NorbotNorway/KiCadTeensyFolkracePro/README.md

# KiCadTeensyFolkracePro
PCB made with KiCad. For Teensy and i2c GP2Y... sensor

(The JST SH 1mm connectors are from http://www.kicadlib.org/)
