NorbotNorway/KiCadTeensyFolkracePro/Schematic/KiCadTeensyFolkraceProSchematic.pdf

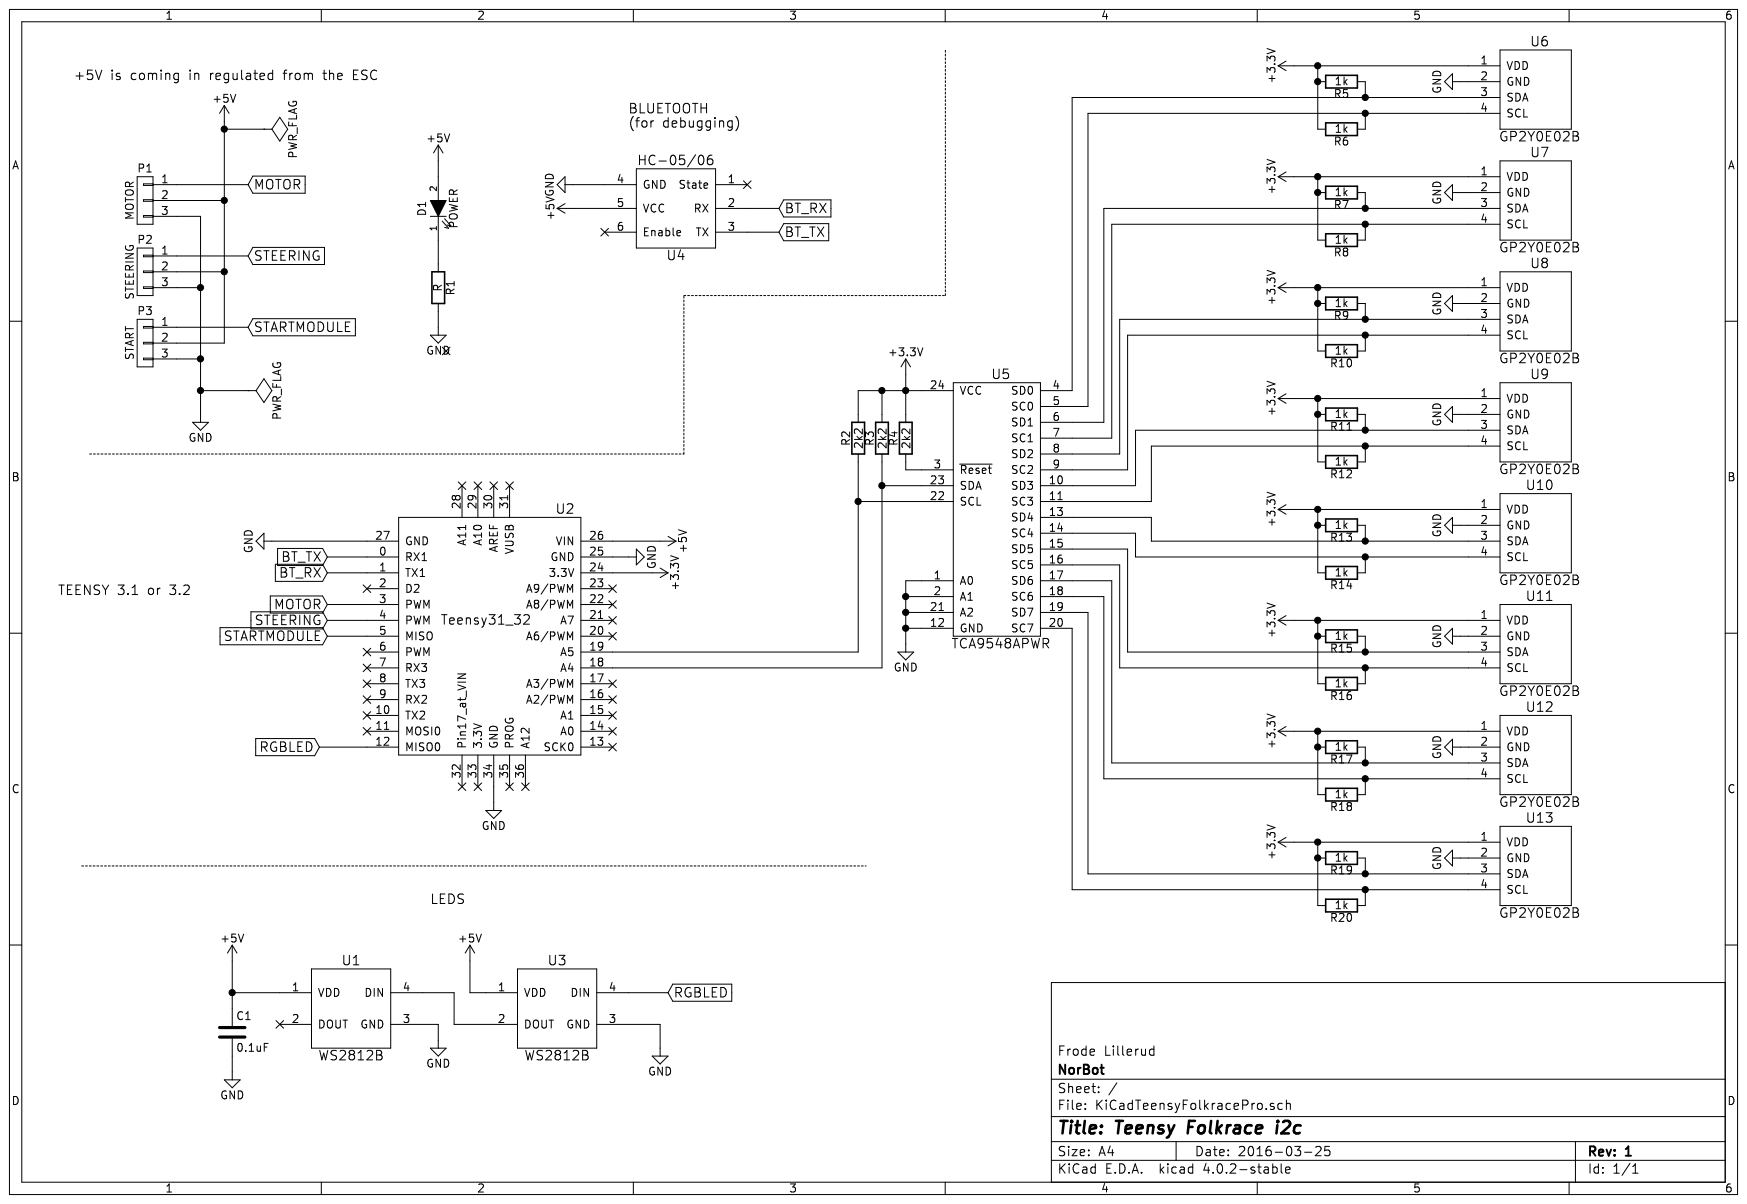
[picture p1: page 1]
