NorbotNorway/KiCadTeensyFolkracePro/KiCadTeensyFolkracePro.kicad_pcb

## KiCad design KiCadTeensyFolkracePro.kicad_pcb (2016-04-30)

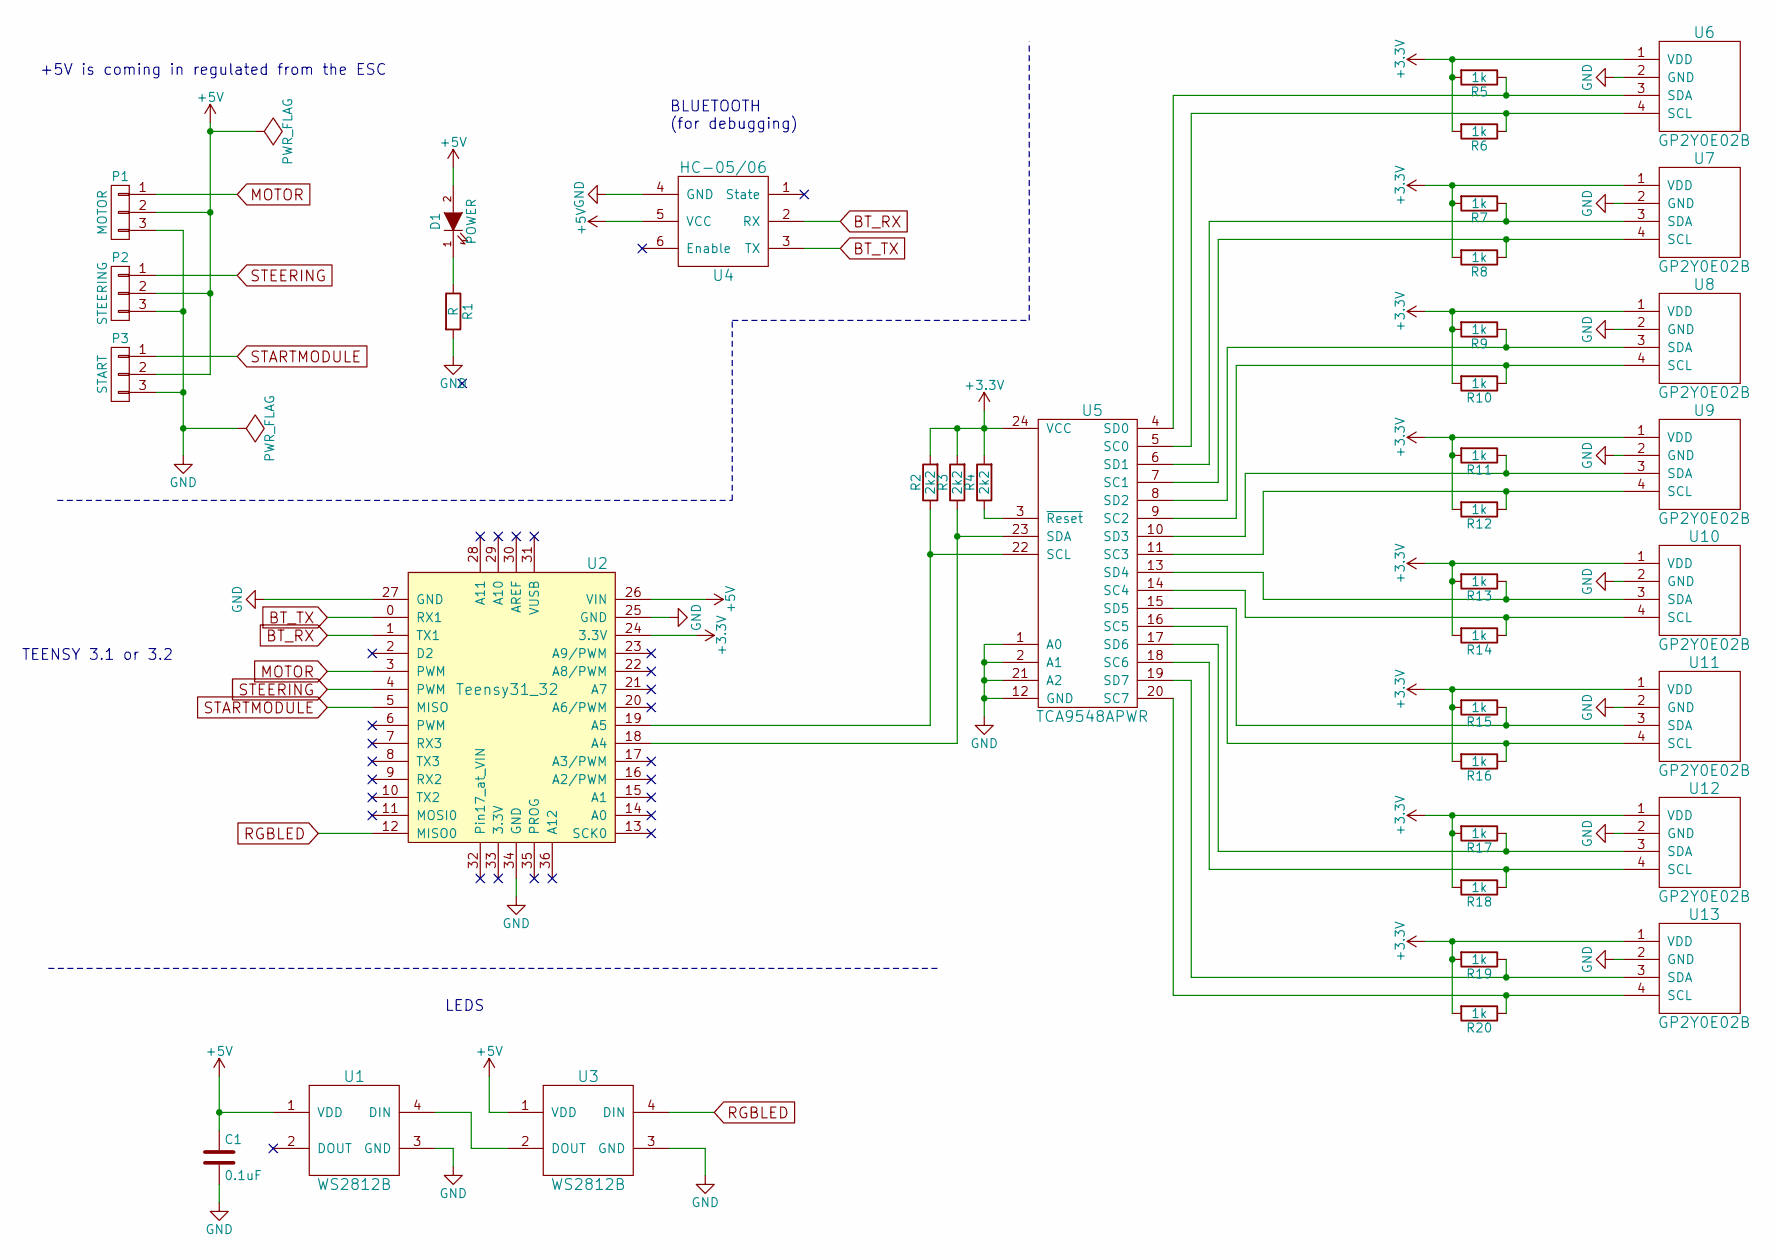
[picture p2: schematic KiCadTeensyFolkracePro.sch, Teensy Folkrace i2c]

Parts:
C1: 0.1uF; C_0805
D1: POWER; R_0603
P1: MOTOR; Pin_Header_Straight_1x03
P2: STEERING; Pin_Header_Straight_1x03
P3: START; Pin_Header_Straight_1x03
R1: R; R_0603
R2, R3, R4: 2k2; R_0603
R5, R6, R7, R8, R9, R10, R11, R12, R13, R14, R15, R16, R17, R18, R19, R20: 1k; R_0603
U1, U3: WS2812B
U2: Teensy31_32; Teensy-3.1_3.2
U4: HC-05/06; Pin_Header_Straight_1x06
U5: TCA9548APWR; TSSOP-24_4.4x7.8mm_Pitch0.65mm
U6, U7, U8, U9, U10, U11, U12, U13: GP2Y0E02B; JST-BM-04B-SRSS-TB

Connections:
+3V3: R2.2, R3.2, R4.2, R5.2, R6.2, R7.2, R8.2, R9.2, R10.2, R11.2, R12.2, R13.2, R14.2, R15.2, R16.2, R17.2, R18.2, R19.2, R20.2, U2.24 (3.3V), U5.24 (VCC), U6.1 (VDD), U7.1 (VDD), U8.1 (VDD), U9.1 (VDD), U10.1 (VDD), U11.1 (VDD), U12.1 (VDD), U13.1 (VDD)
+5V: C1.1, D1.2 (A), P1.2, P2.2, P3.2, U1.1 (VDD), U2.26 (VIN), U3.1 (VDD), U4.5 (VCC)
BT_RX: U2.1 (TX1), U4.2 (RX)
BT_TX: U2.0 (RX1), U4.3 (TX)
GND: C1.2, P1.3, P2.3, P3.3, R1.2, U1.3 (GND), U2.25 (GND), U2.27 (GND), U2.34 (GND), U3.3 (GND), U4.4 (GND), U5.1 (A0), U5.2 (A1), U5.12 (GND), U5.21 (A2), U6.2 (GND), U7.2 (GND), U8.2 (GND), U9.2 (GND), U10.2 (GND), U11.2 (GND), U12.2 (GND), U13.2 (GND)
MOTOR: P1.1, U2.3 (PWM)
unnamed: D1.1 (K), R1.1
unnamed: R2.1, U2.19 (A5), U5.22 (SCL)
unnamed: R3.1, U2.18 (A4), U5.23 (SDA)
unnamed: R4.1, U5.3 (~Reset)
unnamed: R5.1, U5.4 (SD0), U6.3 (SDA)
unnamed: R6.1, U5.5 (SC0), U6.4 (SCL)
unnamed: R7.1, U5.6 (SD1), U7.3 (SDA)
unnamed: R8.1, U5.7 (SC1), U7.4 (SCL)
unnamed: R9.1, U5.8 (SD2), U8.3 (SDA)
unnamed: R10.1, U5.9 (SC2), U8.4 (SCL)
unnamed: R11.1, U5.10 (SD3), U9.3 (SDA)
unnamed: R12.1, U5.11 (SC3), U9.4 (SCL)
unnamed: R13.1, U5.13 (SD4), U10.3 (SDA)
unnamed: R14.1, U5.14 (SC4), U10.4 (SCL)
unnamed: R15.1, U5.15 (SD5), U11.3 (SDA)
unnamed: R16.1, U5.16 (SC5), U11.4 (SCL)
unnamed: R17.1, U5.17 (SD6), U12.3 (SDA)
unnamed: R18.1, U5.18 (SC6), U12.4 (SCL)
unnamed: R19.1, U5.19 (SD7), U13.3 (SDA)
unnamed: R20.1, U5.20 (SC7), U13.4 (SCL)
unnamed: U1.4 (DIN), U3.2 (DOUT)
RGBLED: U2.12 (MISO0), U3.4 (DIN)
STARTMODULE: P3.1, U2.5 (MISO)
STEERING: P2.1, U2.4 (PWM)

Notes on the sheet:
+5V is coming in regulated from the ESC
BLUETOOTH (for debugging)
LEDS
TEENSY 3.1 or 3.2

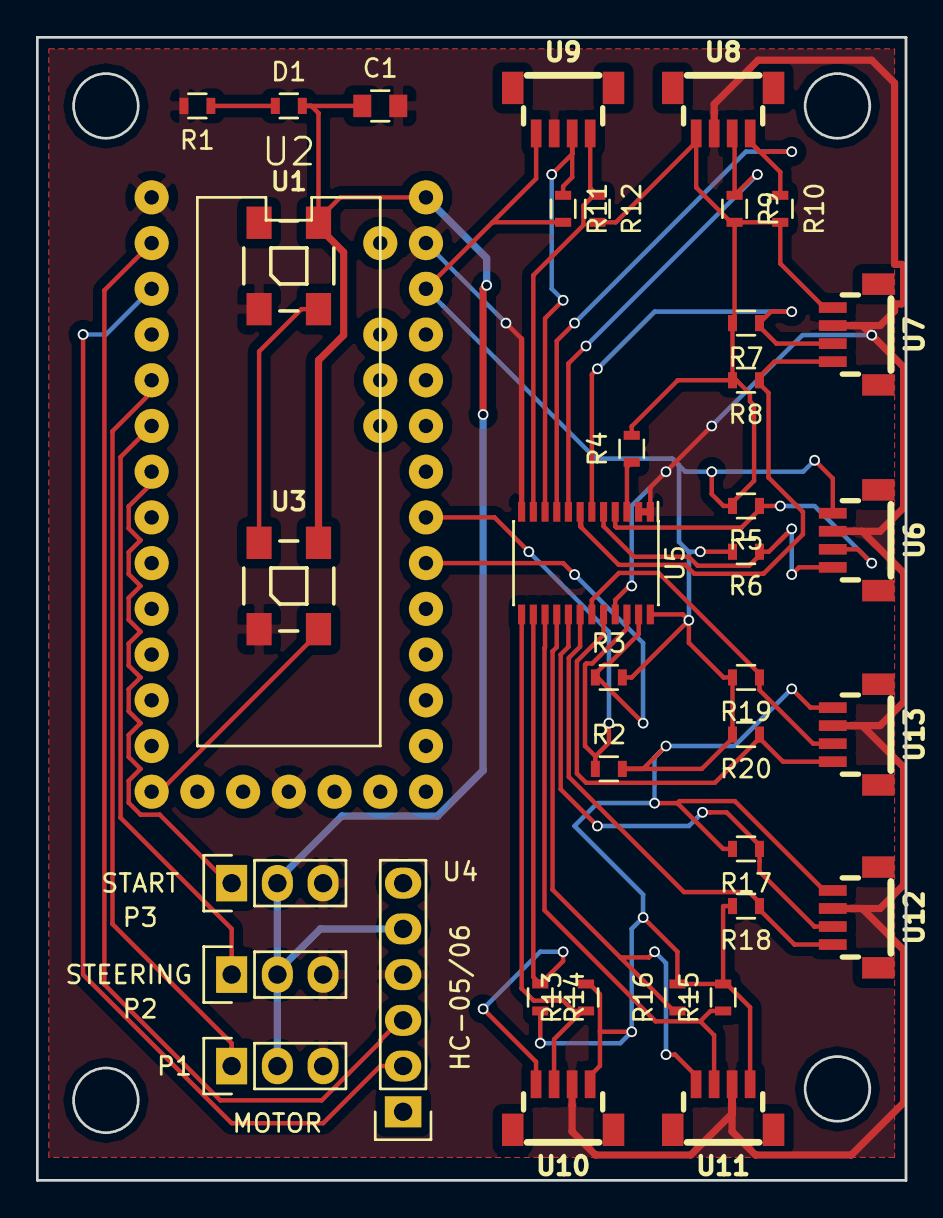
[picture p3: board KiCadTeensyFolkracePro.kicad_pcb from above]

Board: 2 copper layers, 48.3 x 63.5 mm, 38 parts (0 on the bottom side), 30 nets.
