NorbotNorway/KiCadTeensyFolkracePro/Problems.txt

Problems with this card:

- The 4-pin sensorheaders are reversed. They don't match the colorcodes on the wires. Need to mirror the connections. Switch pins 1 and 4, and 2 and 3. The connectors doesn't have to be along the edge of the board.

- Bluetooth header is too close to the 3-pin headers. Bluetooth header should be turned around, or moved. Maybe move it to the back, and make it a right-angle connector which points bluetooth device backwards?

- Too big. Card should be slimmer, and longer.

- Startmodule should be plugged directly into a _female_ 3 or 4-pin header. Note the order of the pins!

- LEDS in the front of the PCB which can be used for debugging?

- Power to Startmodule should come from Teensy digital pin, so that it can be powercycled via software. How much current does it draw, and how much can output pin from Teensy supply?

- Need a way to figure out how much juice is left in the battery...

- PCB needs better indication of which connector is which
