NorbotNorway/KiCadTeensyFolkracePro/Arduino/folkracer/config.h

//Define address location in EEPROM for each variable
#define SETTING_SPEED 1
#define SETTING_MAX_SPEED 2 //Set the maximum speed of the motor, in percentage
#define SETTING_AVG 3
#define SETTING_DISABLE_MOTOR 4 //Set to something other than 0 to disable motor.
#define SETTING_PLOT_SPEED 5    //If set then write speeds to Serial for plotting
#define SETTING_PLOT_SENSORS 6  //If set then write sensorvalues to Serial for plotting
#define SETTING_STEERING_MIN 7  //us, NB two bytes!
#define SETTING_STEERING_MAX 9  //us, NB two bytes!
#define SETTING_CRASH_DIST 11   //cm, centimeters to wall from front sensor for detecting crash
#define SETTING_MIN_SPEED 12    //The minimum speed before motor stalls. Do not go slower than this.
#define SETTING_TURN_GAIN 13    //Multiplier for steering. Higher number gives more agressive turning.
#define SETTING_LOOP_DELAY 14   //Milliseconds to delay each loop
#define SETTING_REDUCE_SPEED_ANGLE 15 //Angle (degrees) which causes car to go at slower speed
#define SETTING_REDUCE_SPEED_BY 16  //Multiplier used to reduce speed while turning. F.ex 2 will half the speed.
#define SETTING_REVERSE_SPEED 17  //Speed to use when reversing

//TCA9548APWR (https://learn.adafruit.com/adafruit-tca9548a-1-to-8-i2c-multiplexer-breakout?view=all)
#define TCA_ADDRESS 0x70

//const int SERVO_STEERING_MIN = 1300; //us
//const int SERVO_STEERING_MAX = 1700; //us
const int SERVO_MOTOR_MAX = 1900;
const int SERVO_MOTOR_MIN = 1100;
const int LED_SLOW_BLINK = 800; //ms
const int LED_FAST_BLINK = 100; //ms

//Serial
const int SERIAL_BAUD_USB = 9600;
const int SERIAL_BAUD_BLUETOOTH = 9600;

//Pins
const int LED_PIN = 13;
const int SERVO_MOTOR_PIN = 3;
const int SERVO_STEERING_PIN = 4;
const int STARTMODULE_PIN = 5;

//Startmodule
enum startmoduleStates {
  WAITING,
  RUNNING,
  STOP,
  MANUAL
};

/*
//http://forum.arduino.cc/index.php/topic,44702.0.html
template <class T> int EEPROM_writeAnything(int ee, const T& value)
{
   const byte* p = (const byte*)(const void*)&value;
   int i(0);
   for (; i < sizeof(value); ++i)
       EEPROM.write(ee++, *p++);
   return i;
}


template <class T> int EEPROM_readAnything(int ee, T& value)
{
   byte* p = (byte*)(void*)&value;
   int i (0);
   for (; i < sizeof(value); ++i)
       *p++ = EEPROM.read(ee++);
   return i;
}
*/
