NorbotNorway/KiCadTeensyFolkracePro/Arduino/folkracer/steering.ino

void turnTo(int degrees)
{
  int steeringMin = car.config.servo_steering_min;
  int steeringMax = car.config.servo_steering_max;
  
  int microseconds = map(degrees, -90, 90, steeringMin, steeringMax);
  microseconds = constrain(microseconds, steeringMin, steeringMax);
  servoSteering.writeMicroseconds(microseconds);
  //TraceNoLine("Steering to");
  //Trace(degrees);
}
