NorbotNorway/KiCadTeensyFolkracePro/(commit log)

2016-04-30 Arduino files
    [KiCadTeensyFolkracePro-B.Cu.gbr, KiCadTeensyFolkracePro-B.Mask.gbr, KiCadTeensyFolkracePro-B.SilkS.gbr, KiCadTeensyFolkracePro-Edge.Cuts.gbr, KiCadTeensyFolkracePro-F.Cu.gbr, KiCadTeensyFolkracePro-F.Mask.gbr, KiCadTeensyFolkracePro-F.SilkS.gbr, KiCadTeensyFolkracePro.drl]
2016-05-01 Plotting from all three sensors works
2016-05-01 Started on Steering.
2016-05-01 Command 'steering' works. Fixed 'led.blink' command.
    [Command.ino, folkracer.ino]
2016-05-01 Motor works
2016-05-02 Added interrupt for startmodule. Doesn't work yet.
    [StartModule.ino, folkracer.ino]
2016-05-04 Minor changes while testing steering
2016-07-23 Schematic added
    [KiCadTeensyFolkracePro.sch]
